erickmendezvaldebenito-lab/Percu-Synt/Imagenes/circuito.png

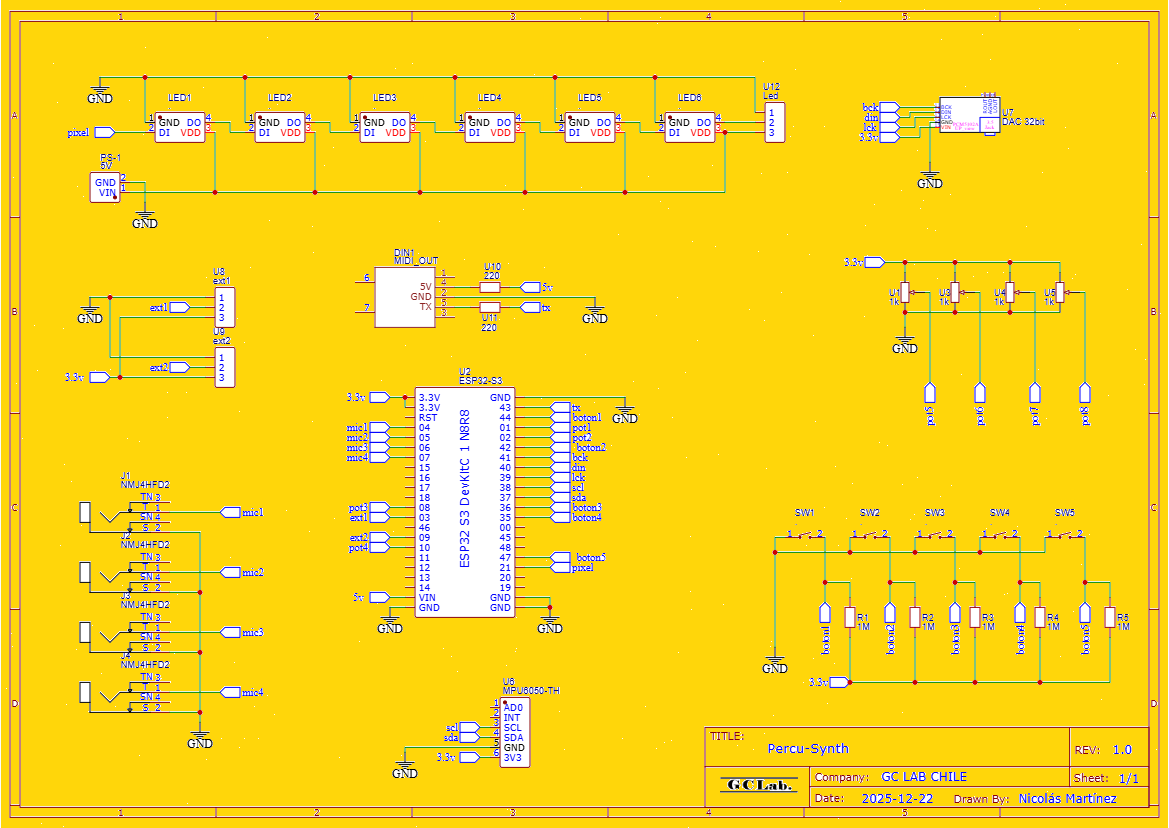
Imagenes/circuito.png
