erickmendezvaldebenito-lab/Percu-Synt/Imagenes/percu-synth modelo 3d.jpeg

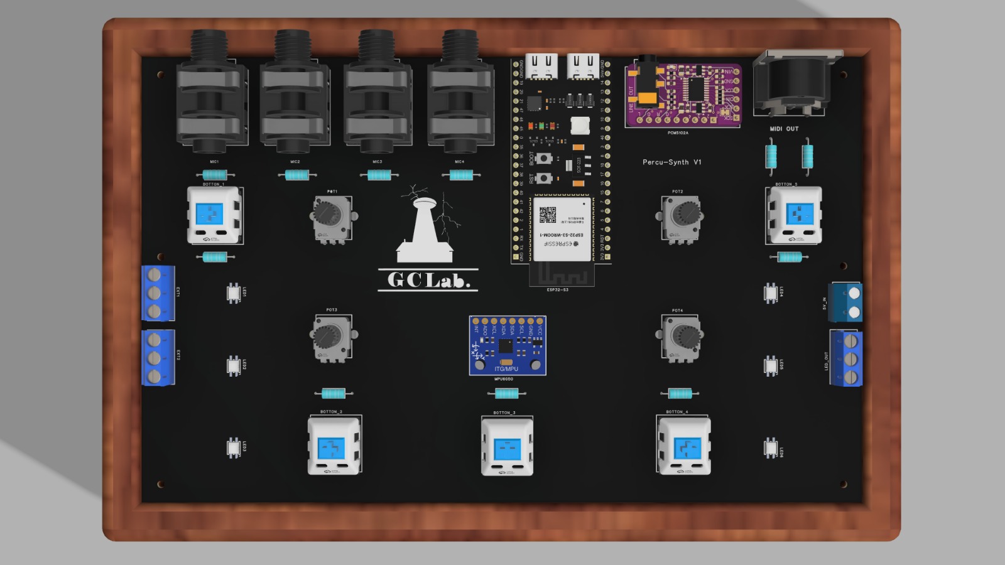
Imagenes/percu-synth modelo 3d.jpeg
