erickmendezvaldebenito-lab/Percu-Synt/tools/campos_visual/touchdesigner/salida.png

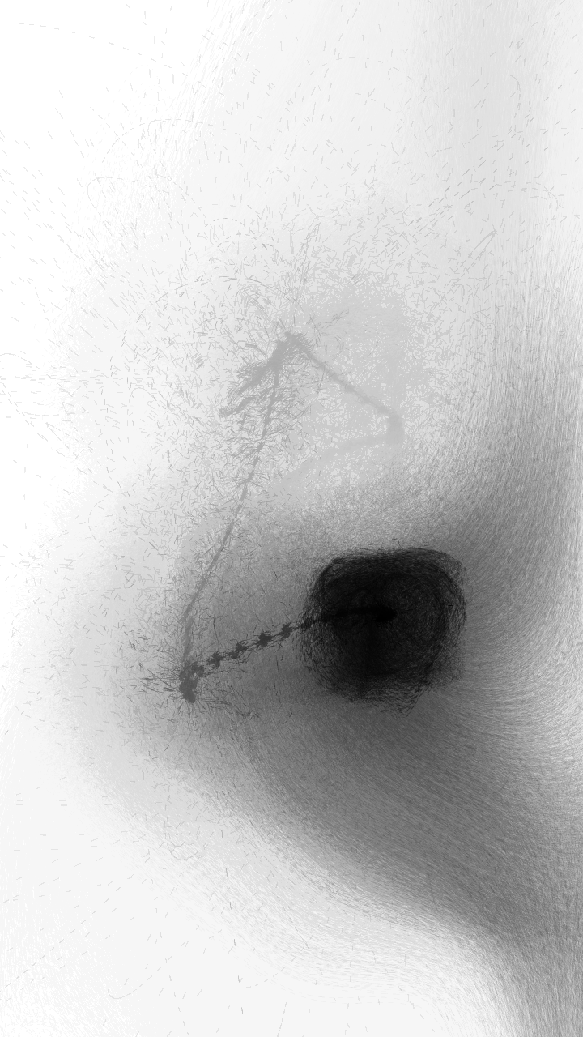
tools/campos_visual/touchdesigner/salida.png
