erickmendezvaldebenito-lab/Percu-Synt/tools/campos_visual/touchdesigner/salida_vivo.png

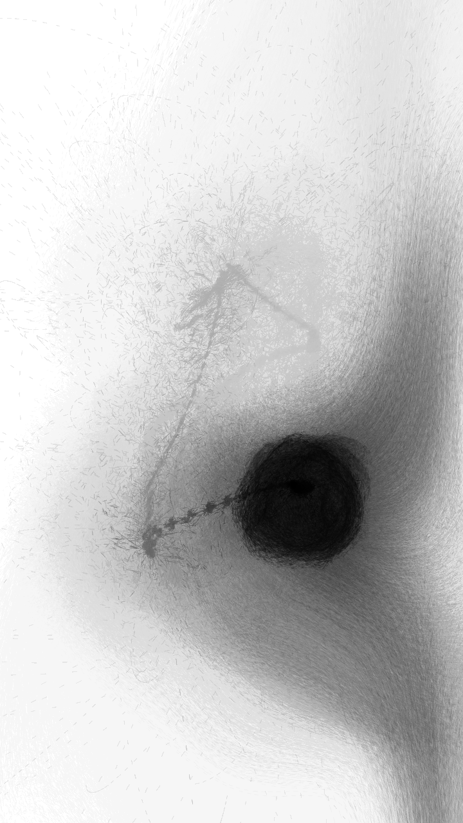
tools/campos_visual/touchdesigner/salida_vivo.png
