erickmendezvaldebenito-lab/Percu-Synt/tools/step_sequencer_loader/index.html

PERCUSYNTH STEP SEQUENCER · LIVE

desconectado

MIDI ▶ HABILITAR IN OUT CONECTAR ↑ PUSH PATRÓN

SECUENCIADOR SAMPLES & FIRMWARE

▶ PLAY ■ STOP ⟲ RESET CLEAR EJEMPLO RANDOM STEP —/16

PATRÓN · 6×16 — click on/off · click nombre mute

SÍNTESIS & FX — monitor en vivo (CC ch16)

BPM 120

SWING 0%

PITCH 1.00×

HPF 20Hz

LPF 12kHz

VOL 60%

DELAY off

FILL OFF

BEAT REP OFF

REVERSE OFF

DROP OFF

SAMPLES (carga MP3/WAV/OGG por pista)

Los samples se hornean en el firmware. Después de cargar todos, genera un nuevo .ino y flashea.

GENERAR FIRMWARE

⬇ DESCARGAR .INO ⬇ PATRÓN JSON ⬆ IMPORTAR JSON

⚠ Arduino IDE → Tools: Board ESP32S3 Dev Module · USB Mode USB-OTG (TinyUSB) · USB CDC On Boot Disabled · Flash Mode DIO (NO OPI) → Upload.

### RECORTAR SAMPLE

✕

Arrastra las manijas ◄ inicio y fin ► para dejar solo la parte útil.

INICIO 0.00s FIN 0.00s DURACIÓN 0.00s

AUTO SILENCIO ▶ ESCUCHAR RESET CANCELAR ✂ APLICAR
