erickmendezvaldebenito-lab/Percu-Synt/firmwares/z/cargador/cargador.ino

// ==============================================================================================================================================
// PERCU-SYNTH — Z · Cargador de la microSD por USB — GC Lab Chile
// ==============================================================================================================================================
// HARDWARE
// ==============================================================================================================================================
// - ESP32-S3 + módulo microSD (SPI): SCK 14 · MOSI 15 · MISO 16 · CS 17 · 3V3 · GND. Tarjeta en FAT32.
// ==============================================================================================================================================
// ARDUINO IDE
// ==============================================================================================================================================
// - Board: ESP32S3 Dev Module · USB CDC On Boot: Enabled · Flash Mode: DIO · Librerías: sólo las del core (SD, SPI)
// ==============================================================================================================================================
// DESCRIPCIÓN
// ==============================================================================================================================================
// Herramienta temporal: copia archivos del computador a la microSD SIN sacar la tarjeta del módulo. El computador (tools/z_prep/subir_a_sd.py)
// manda por el USB nativo (Serial, CDC) y la placa escribe a 20 MHz y devuelve el CRC32 de lo escrito (y puede releerlo del SD para verificarlo).
// Protocolo (texto, una orden por línea): HOLA · MKDIR ruta · PUT ruta bytes → "LISTO", luego bloques de 16 KB (la placa contesta 'A' a cada
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
