erickmendezvaldebenito-lab/Percu-Synt/(commit log)

2026-11-03 Ejemplos generados por los loaders (samples/)
2026-11-03 Video de presentación
2026-11-03 matriz_oscura: mover el sketch a su carpeta, README y samples.h provisorio (sintético)
    Claude-Session: https://claude.ai/code/session_01AdPvr47iJozkZxZpu1t2dS
2026-11-03 atmosfera_deep: ambiente deep que muta, con escala y capas que crecen con el POT3
    BTN1 play, BTN2 filtro, BTN3 sinte (timbre sigue al POT2), BTN4 delay en el tempo,
    BTN5 pausas sincronizadas; POT1 volumen, POT2 mutacion, POT3 escala y capas, POT4 corte.
    Un solo reloj, todo en grados del modo, escena y modos guardados en la flash del chip.
    Validado en PC contra mocks (0 notas fuera de escala de 13 684, reloj sin deriva, pausas en
    su paso, guardado, nivel). CPU estimada por calibracion contra firmwares con CPU medido en la
    placa, regulador de carga de 2 niveles y -DDIAG=1. No probado en la placa ni escuchado.
    Claude-Session: https://c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
